klassing/Halloween_Ghost/Hardware/_Release_Files_/SCM/Halloween_Ghost_v1_scm.pdf

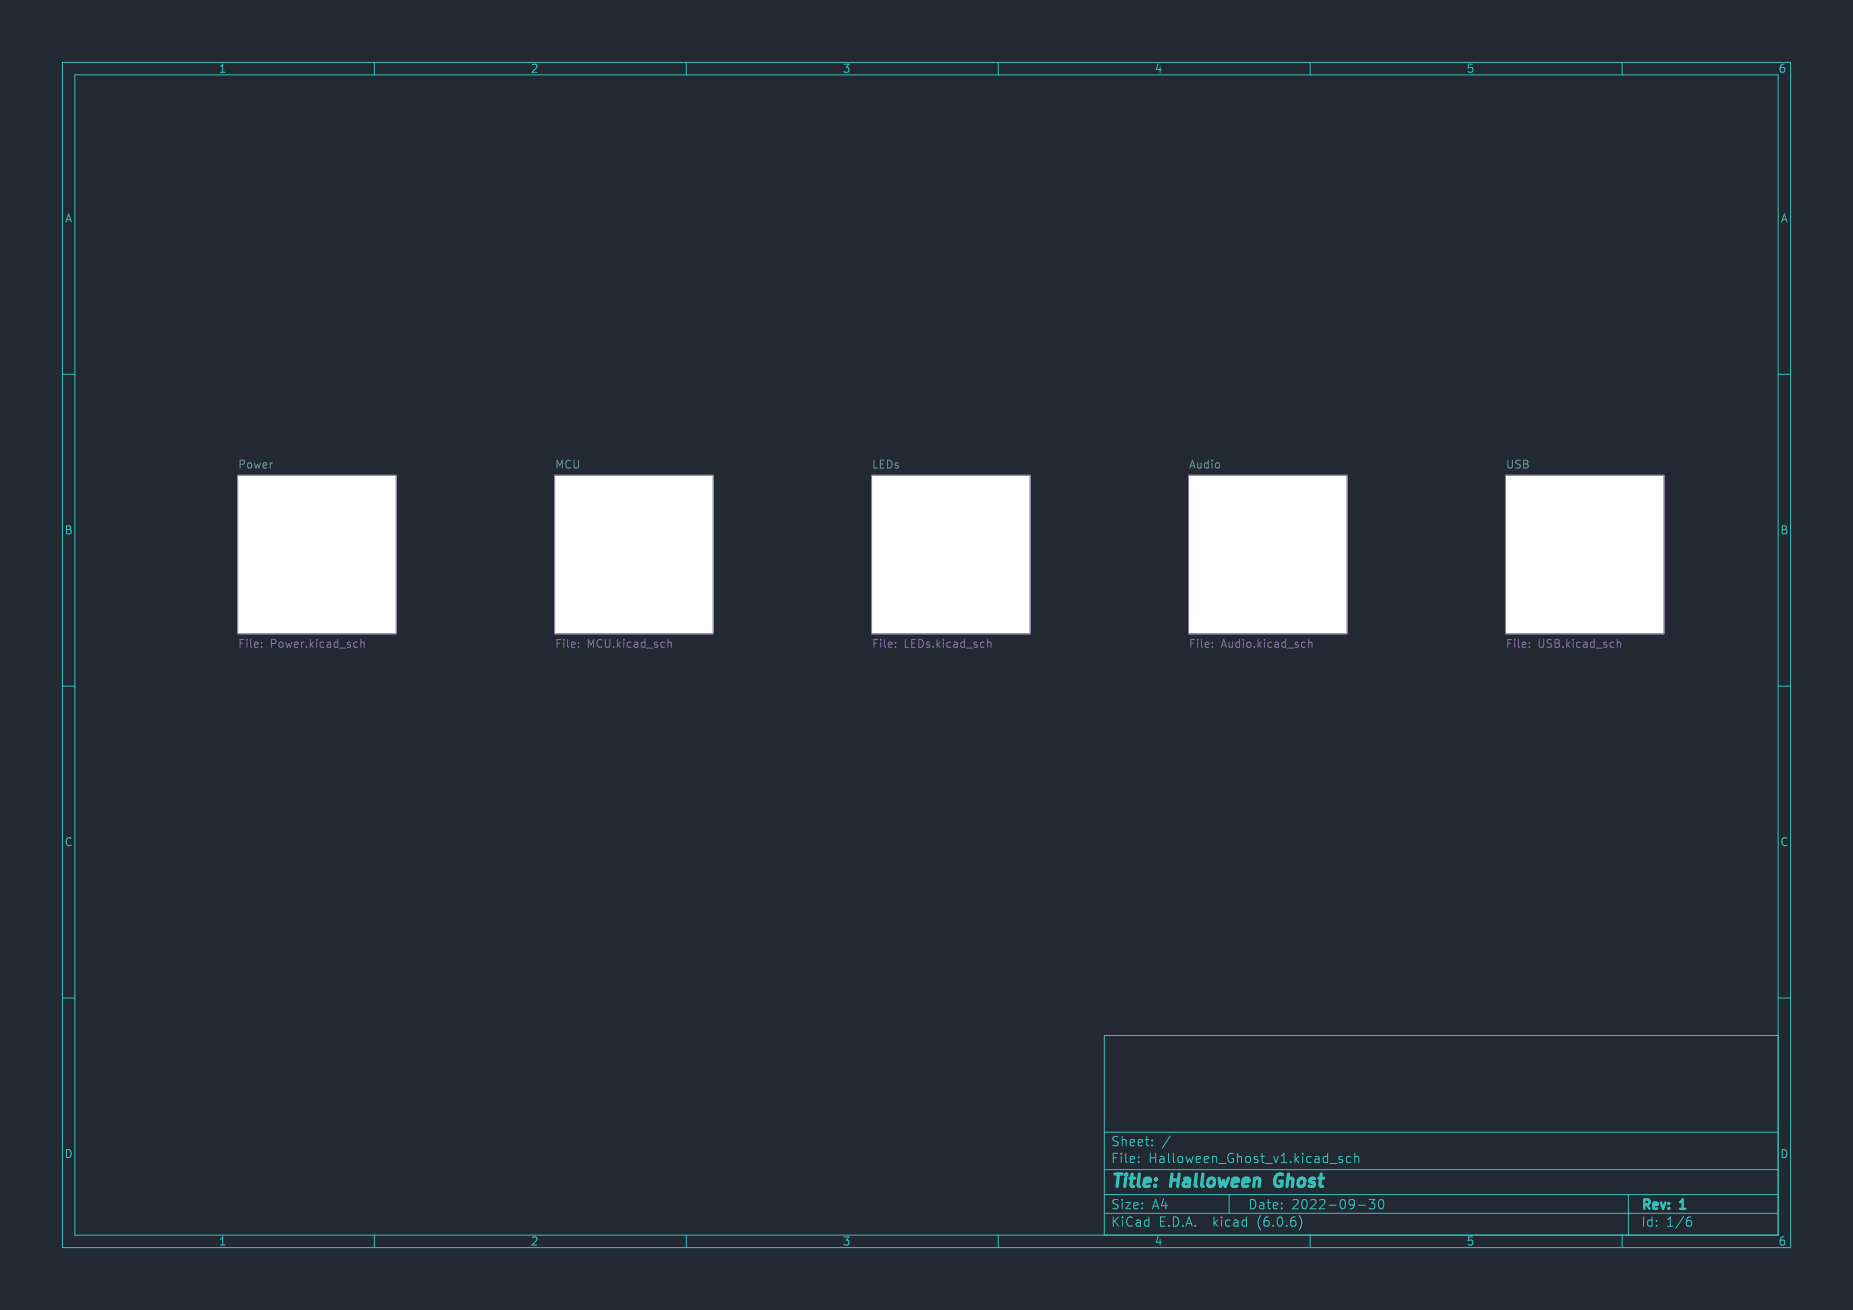
[picture p1: page 1]

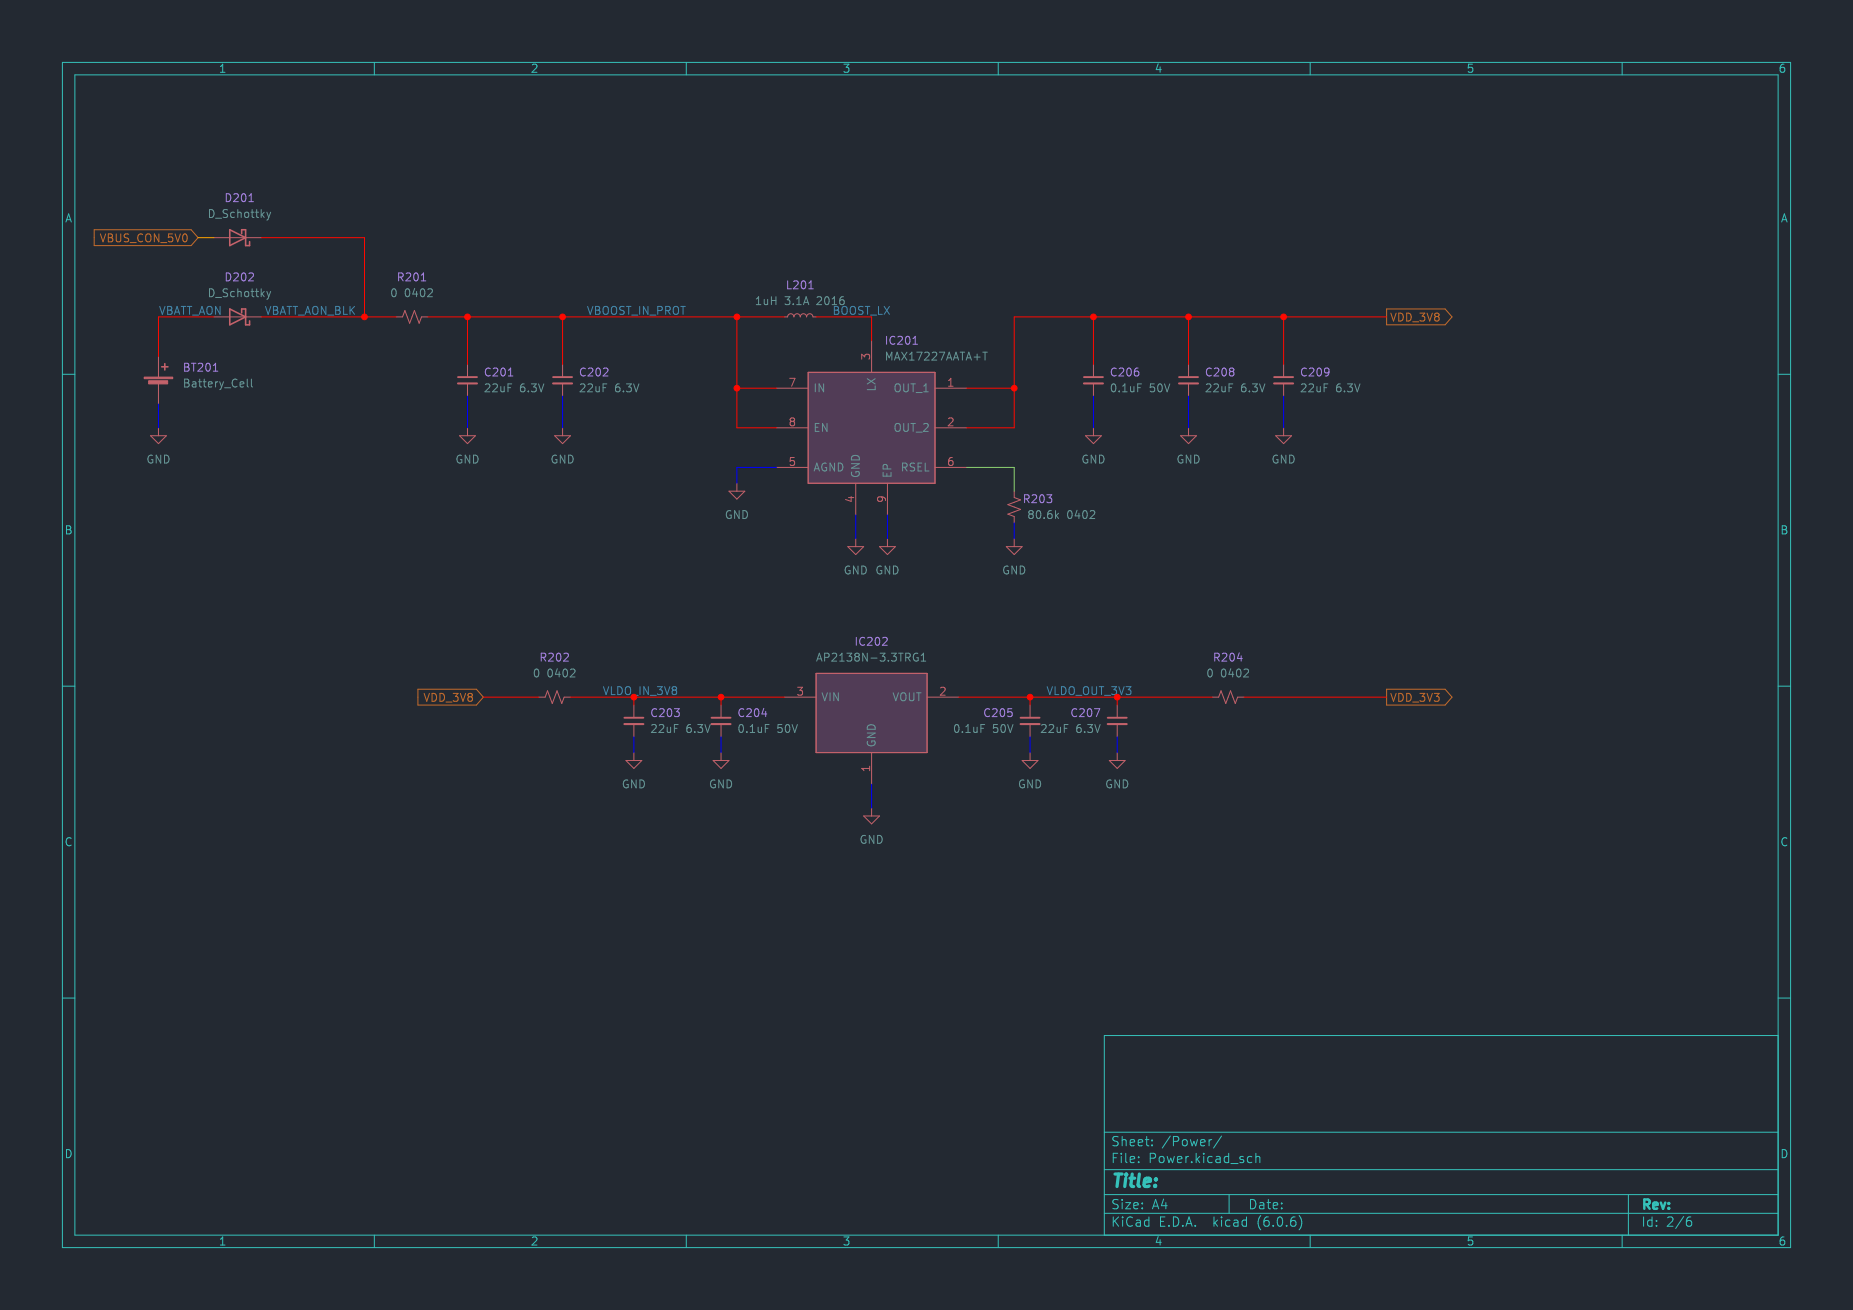
[picture p2: page 2]

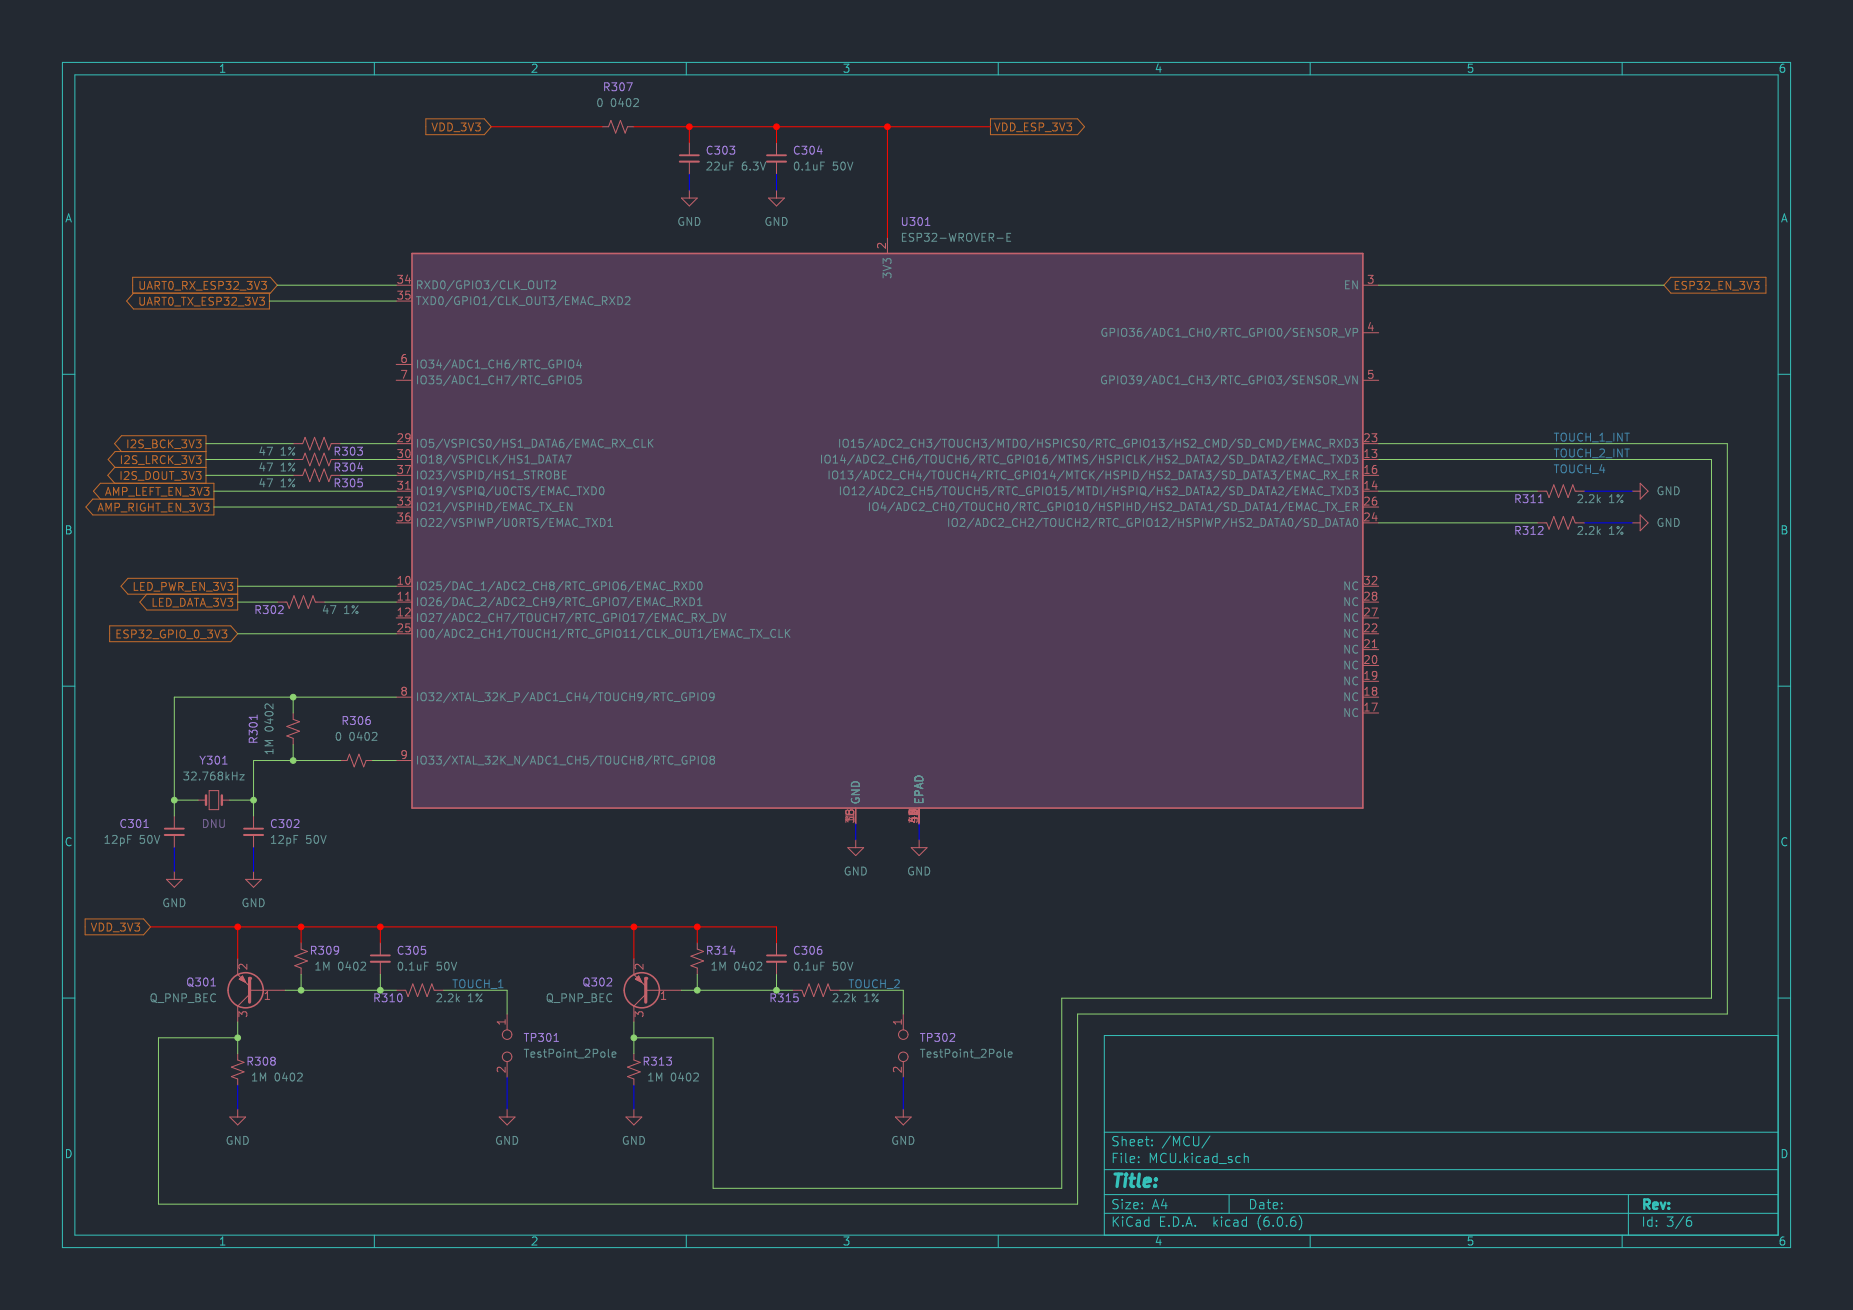
[picture p3: page 3]

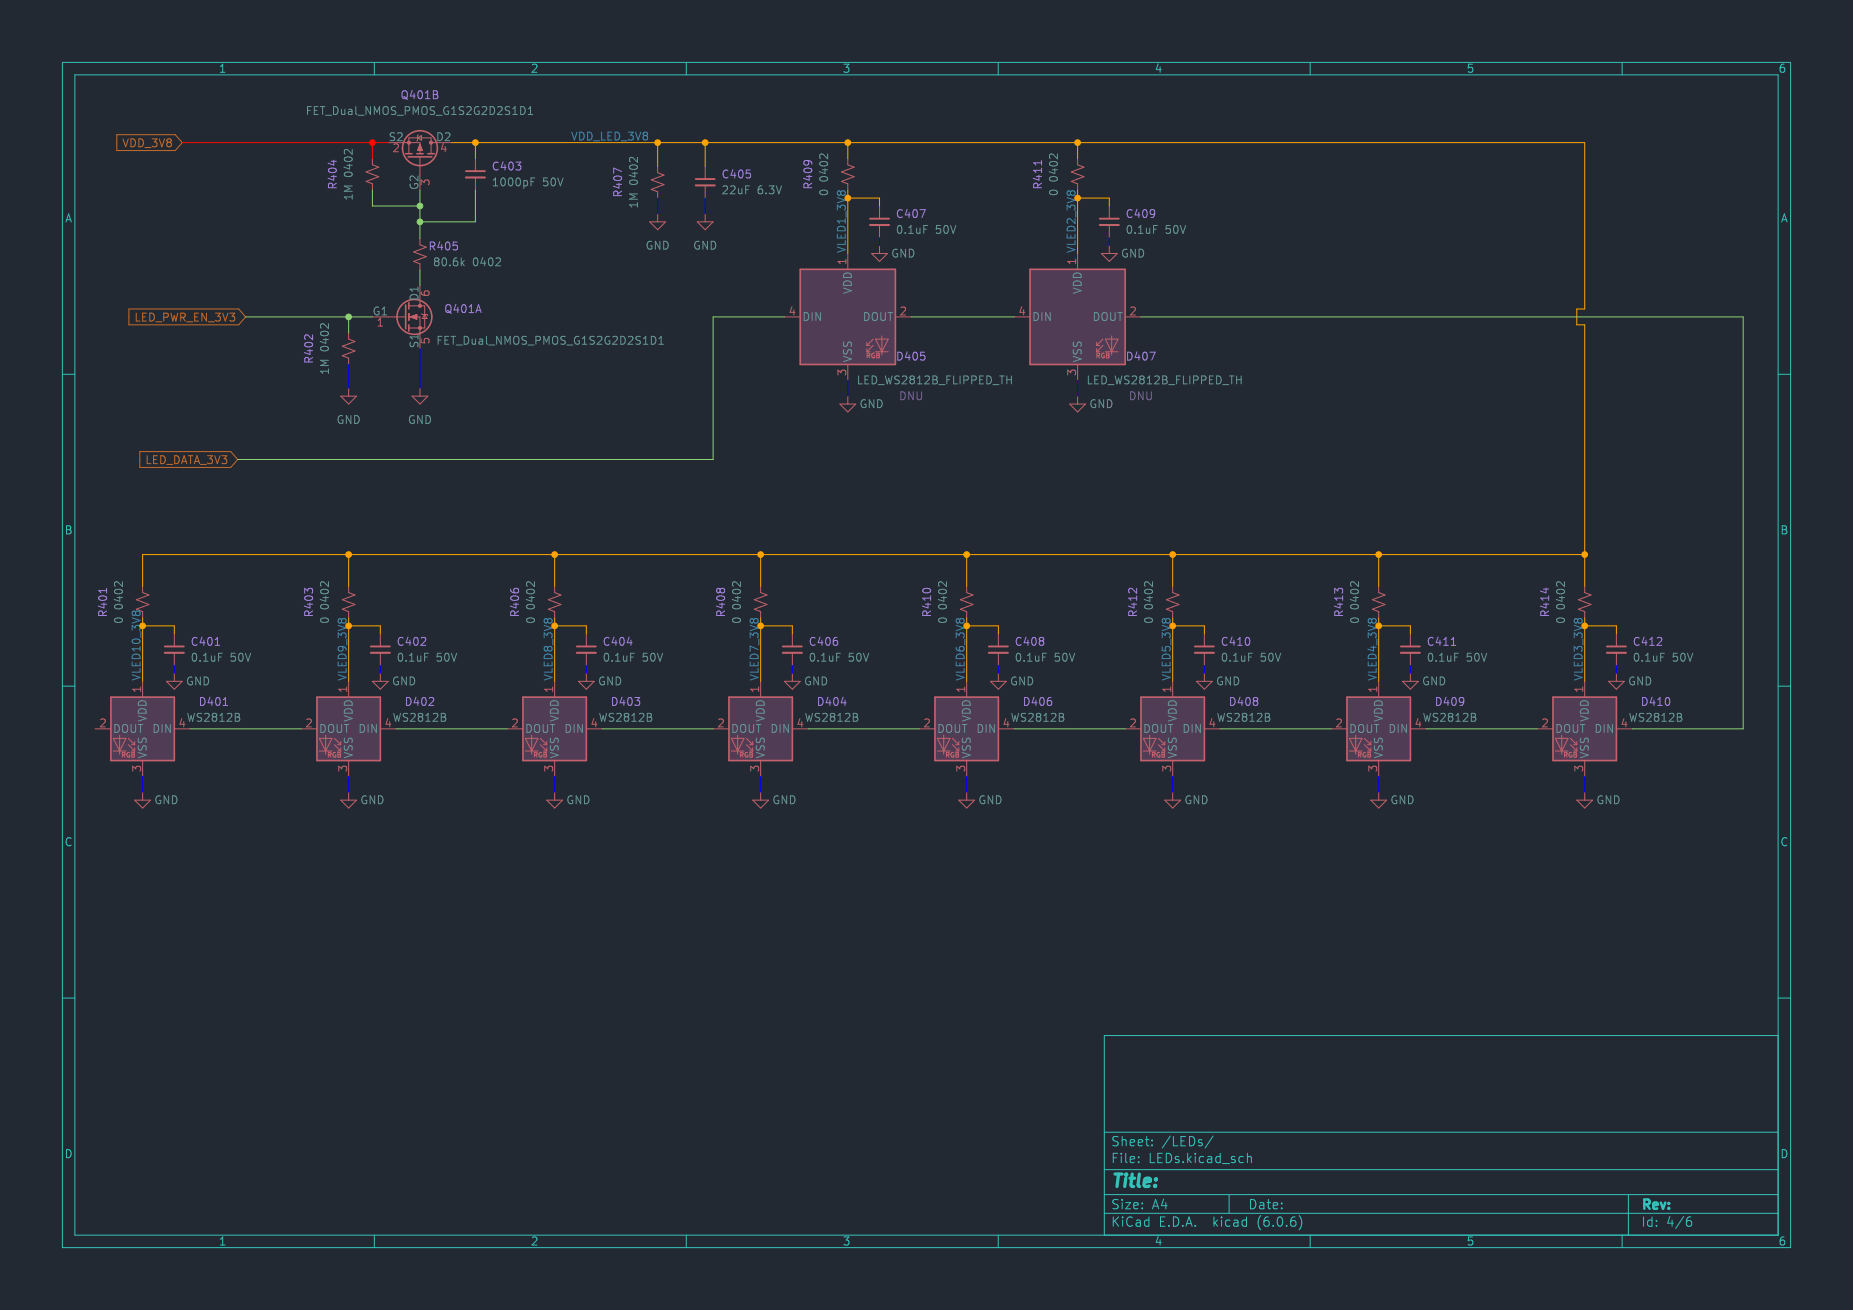
[picture p4: page 4]

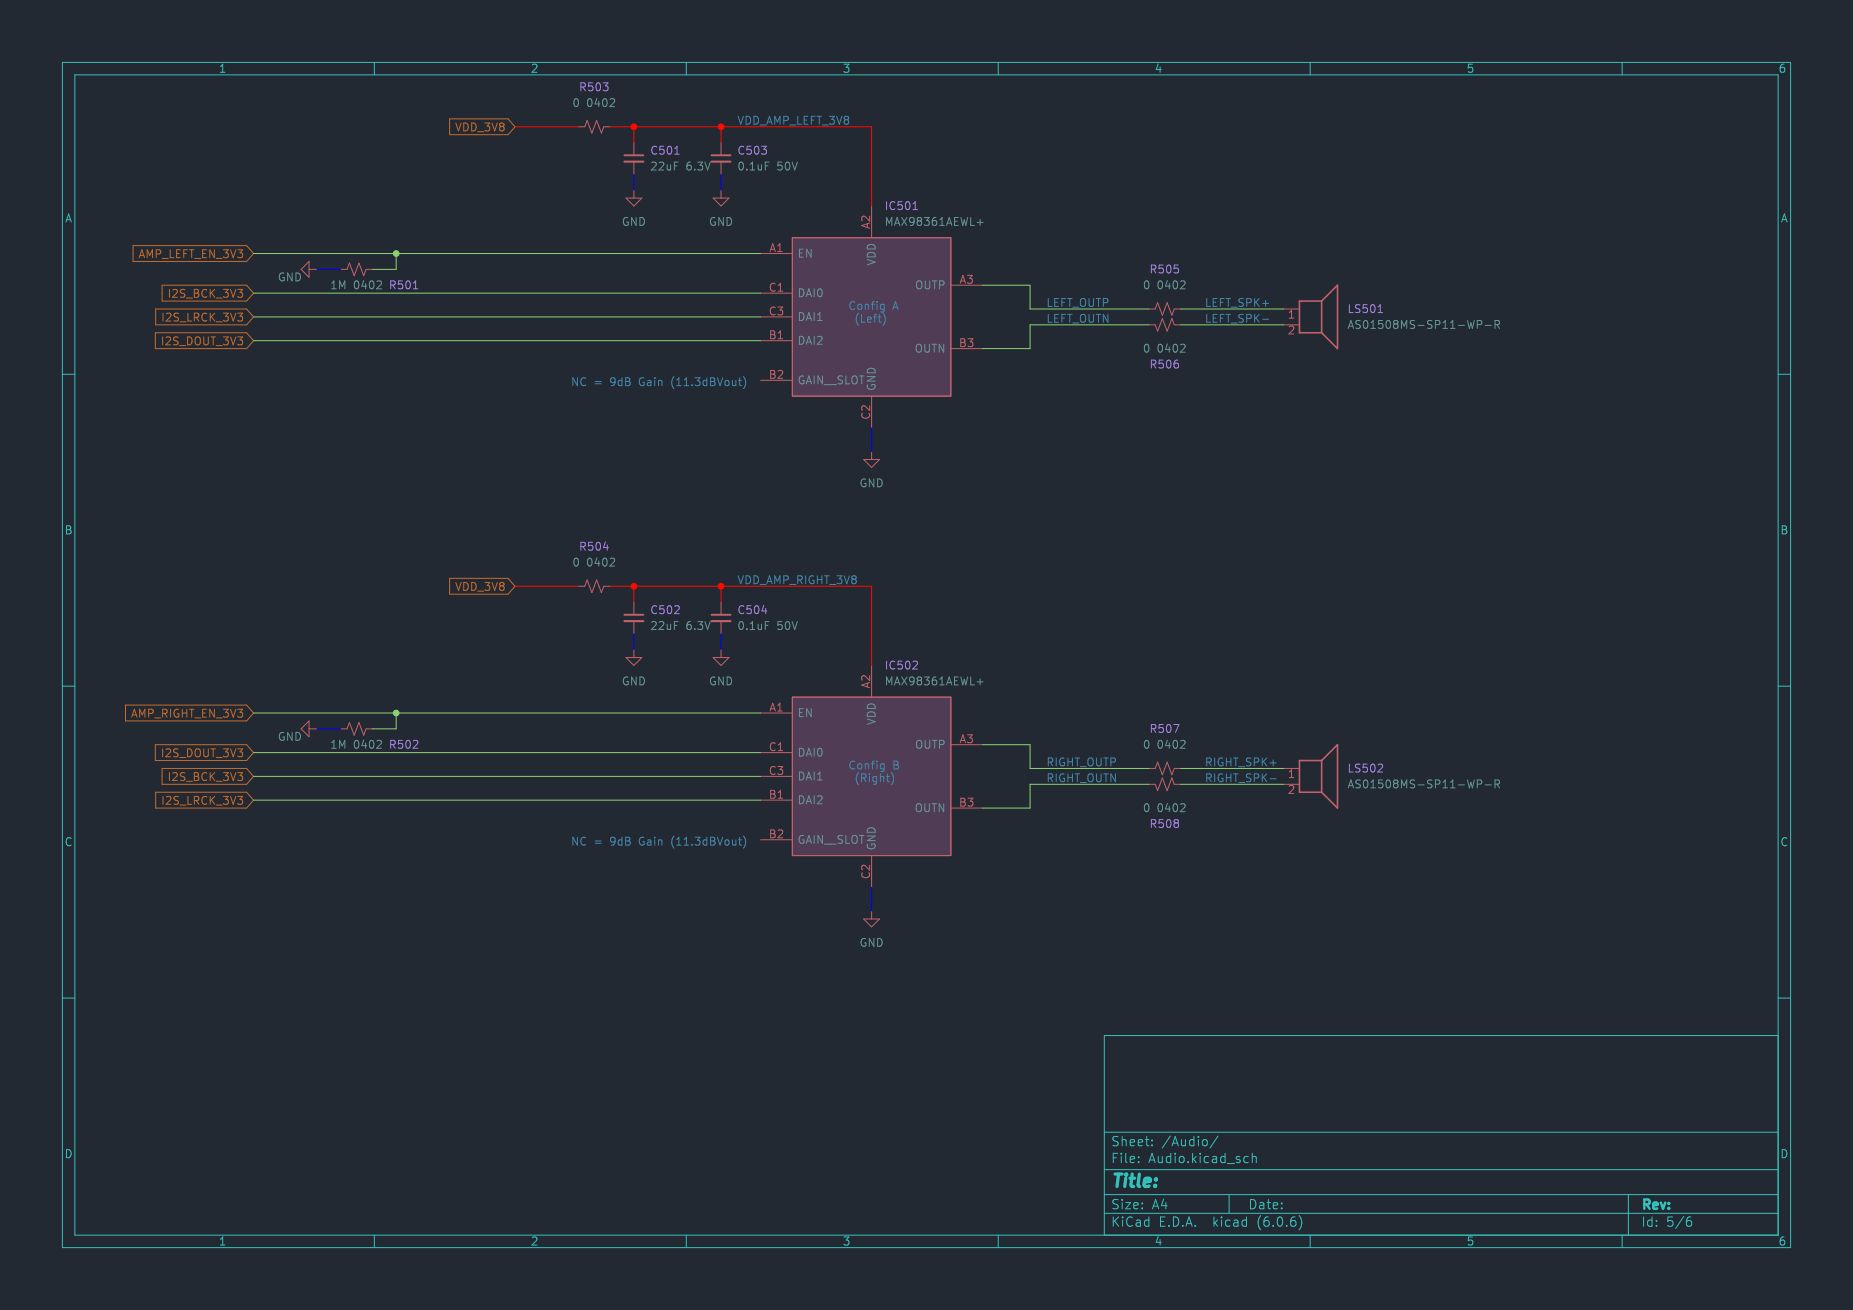
[picture p5: page 5]

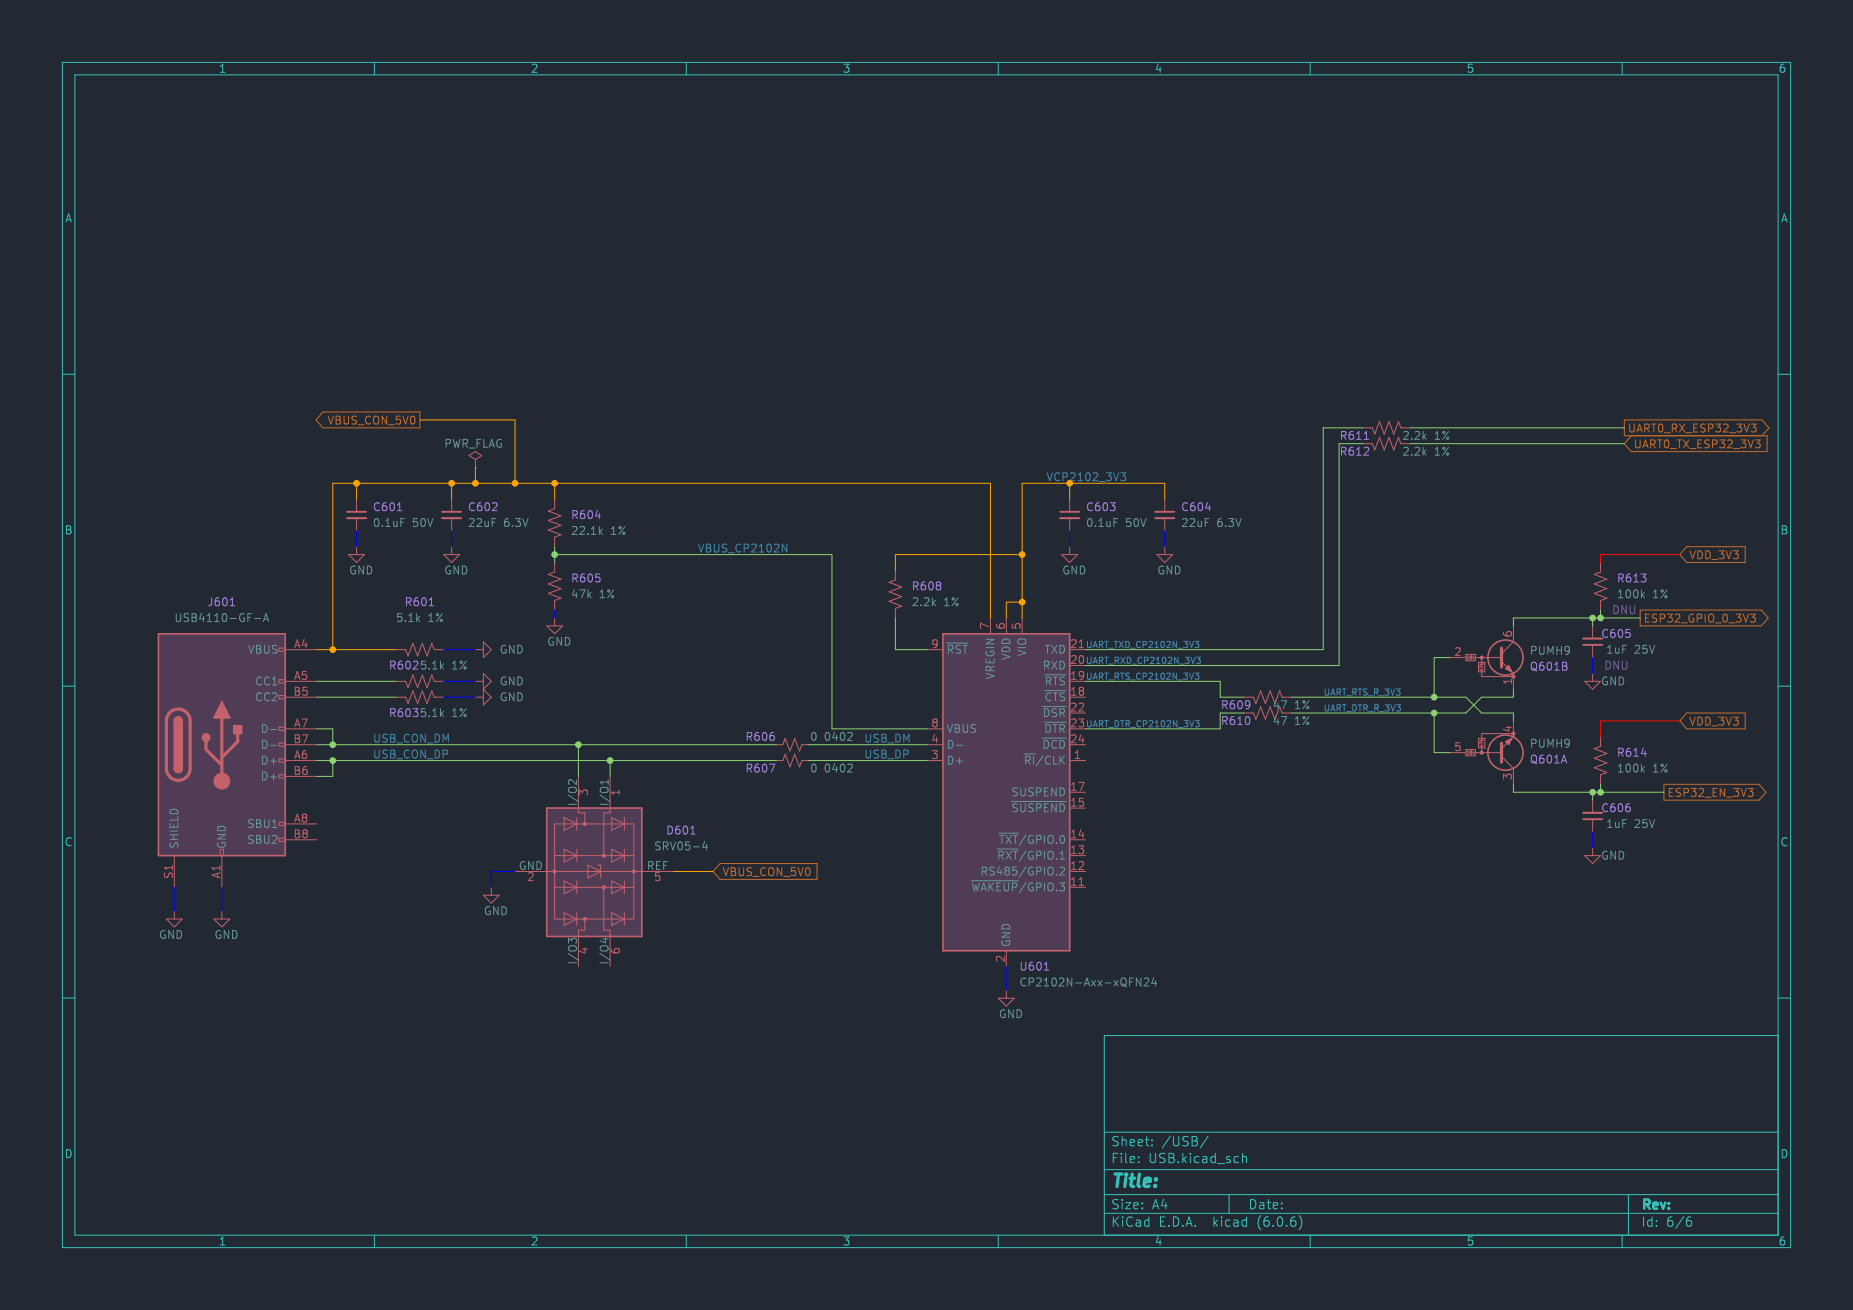
[picture p6: page 6]
