klassing/Halloween_Ghost/Hardware/CAD/Halloween_Ghost_v1.kicad_pcb

## KiCad design Hardware/CAD/Halloween_Ghost_v1.kicad_pcb (2022-10-20)

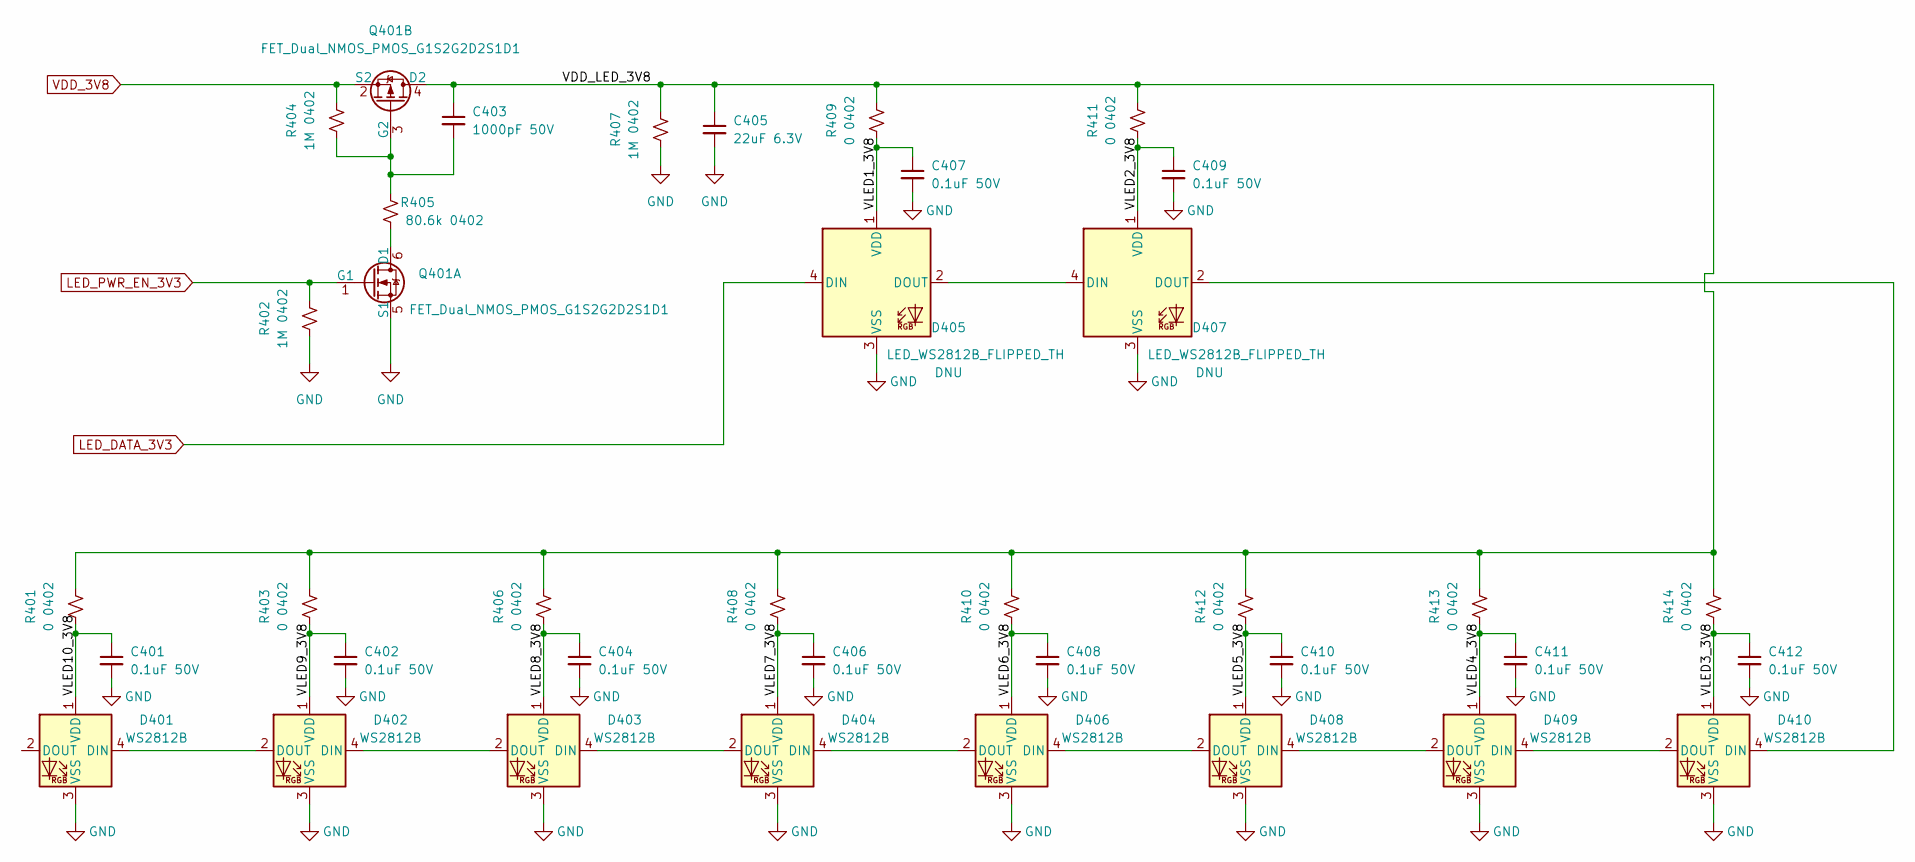
[picture p7: schematic LEDs.kicad_sch]

Parts:
C401, C402, C404, C406, C407, C408, C409, C410, C411, C412: 0.1uF 50V; C_0402_1005Metric; JLC_Cost 0.0061
C403: 1000pF 50V; C_0402_1005Metric; JLC_Cost 0.001
C405: 22uF 6.3V; C_0603_1608Metric; JLC_Cost 0.0044
D401, D402, D403, D404, D406, D408, D409, D410: WS2812B; LED_WS2812B_PLCC4_5.0x5.0mm_P3.2mm; JLC_Cost 0.0962
D405, D407: LED_WS2812B_FLIPPED_TH; Manufacturer_Part_Number WS2812B-V5/W
Q401: FET_Dual_NMOS_PMOS_G1S2G2D2S1D1; TSOT-23-6; JLC_Cost 0.1041
R401, R403, R406, R408, R409, R410, R411, R412, R413, R414: 0 0402; R_0402_1005Metric; JLC_Cost 0.0005
R402, R404, R407: 1M 0402; R_0402_1005Metric; JLC_Cost 0.0005
R405: 80.6k 0402; R_0402_1005Metric; JLC_Cost 0.0005

Connections:
/LEDs/VDD_LED_3V8: C403.1, C405.1, Q401.4 (D2), R401.2, R403.2, R406.2, R407.2, R408.2, R409.2, R410.2, R411.2, R412.2, R413.2, R414.2
/LEDs/VLED1_3V8: C407.1, D405.1 (VDD), R409.1
/LEDs/VLED2_3V8: C409.1, D407.1 (VDD), R411.1
/LEDs/VLED3_3V8: C412.1, D410.1 (VDD), R414.1
/LEDs/VLED4_3V8: C411.1, D409.1 (VDD), R413.1
/LEDs/VLED5_3V8: C410.1, D408.1 (VDD), R412.1
/LEDs/VLED6_3V8: C408.1, D406.1 (VDD), R410.1
/LEDs/VLED7_3V8: C406.1, D404.1 (VDD), R408.1
/LEDs/VLED8_3V8: C404.1, D403.1 (VDD), R406.1
/LEDs/VLED9_3V8: C402.1, D402.1 (VDD), R403.1
/LEDs/VLED10_3V8: C401.1, D401.1 (VDD), R401.1
GND: C401.2, C402.2, C404.2, C405.2, C406.2, C407.2, C408.2, C409.2, C410.2, C411.2, C412.2, D401.3 (VSS), D402.3 (VSS), D403.3 (VSS), D404.3 (VSS), D405.3 (VSS), D406.3 (VSS), D407.3 (VSS), D408.3 (VSS), D409.3 (VSS), D410.3 (VSS), Q401.5 (S1), R402.1, R407.1; also elsewhere on the board
LED_DATA_3V3: D405.4 (DIN); also elsewhere on the board
LED_PWR_EN_3V3: Q401.1 (G1), R402.2; also elsewhere on the board
unnamed: C403.2, Q401.3 (G2), R404.1, R405.2
unnamed: D401.4 (DIN), D402.2 (DOUT)
unnamed: D402.4 (DIN), D403.2 (DOUT)
unnamed: D403.4 (DIN), D404.2 (DOUT)
unnamed: D404.4 (DIN), D406.2 (DOUT)
unnamed: D405.2 (DOUT), D407.4 (DIN)
unnamed: D406.4 (DIN), D408.2 (DOUT)
unnamed: D407.2 (DOUT), D410.4 (DIN)
unnamed: D408.4 (DIN), D409.2 (DOUT)
unnamed: D409.4 (DIN), D410.2 (DOUT)
unnamed: Q401.6 (D1), R405.1
VDD_3V8: Q401.2 (S2), R404.2; also elsewhere on the board

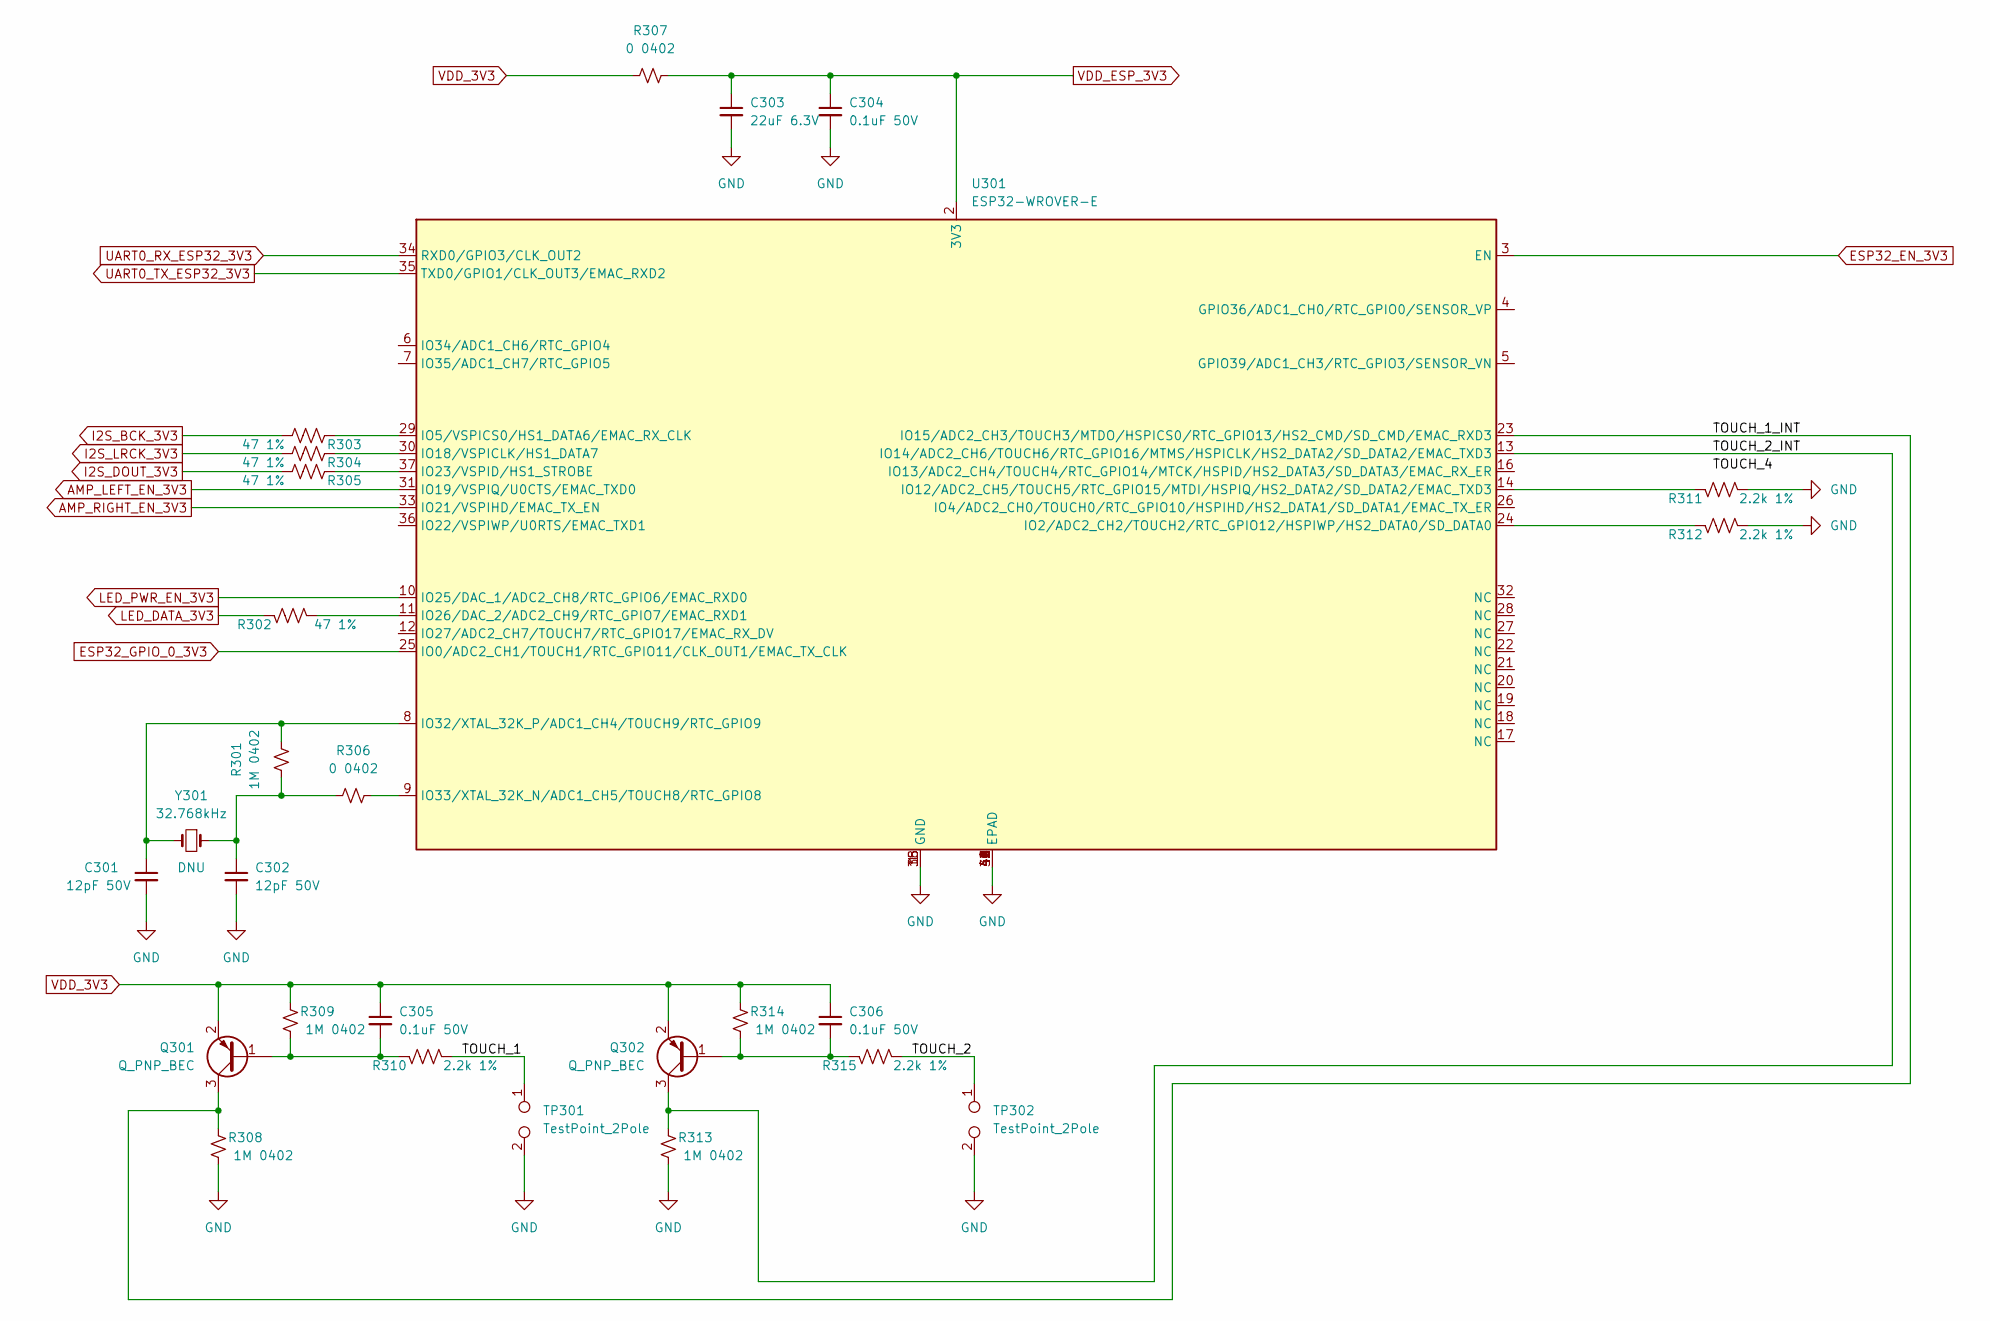
[picture p8: schematic MCU.kicad_sch]

Parts:
C301, C302: 12pF 50V; C_0402_1005Metric; JLC_Cost 0.0061
C303: 22uF 6.3V; C_0603_1608Metric; JLC_Cost 0.0044
C304, C305, C306: 0.1uF 50V; C_0402_1005Metric; JLC_Cost 0.0061
Q301, Q302: Q_PNP_BEC; SOT-23; JLC_Cost 0.0147
R301, R308, R309, R313, R314: 1M 0402; R_0402_1005Metric; JLC_Cost 0.0005
R302, R303, R304, R305: 47 1%; R_0402_1005Metric; Manufacturer_Part_Number RMC10K470FTH; Mouser Part Number 791-RMC10K470FTH
R306, R307: 0 0402; R_0402_1005Metric; JLC_Cost 0.0005
R310, R311, R312, R315: 2.2k 1%; R_0402_1005Metric; Manufacturer_Part_Number RMC10K222FTH; Mouser Part Number 791-RMC10K222FTH
TP301, TP302: TestPoint_2Pole
U301: ESP32-WROVER-E; JLC_MPN ESP32-WROVER-E-N8R8
Y301: 32.768kHz; Crystal_SMD_3215-2Pin_3.2x1.5mm; JLC_Cost 0.2034

Connections:
/MCU/TOUCH_1: R310.1, TP301.1
/MCU/TOUCH_1_INT: Q301.3 (C), R308.1, U301.23 (IO15/ADC2_CH3/TOUCH3/MTDO/HSPICS0/RTC_G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)
/MCU/TOUCH_2: R315.1, TP302.1
/MCU/TOUCH_2_INT: Q302.3 (C), R313.1, U301.13 (IO14/ADC2_CH6/TOUCH6/RTC_GPIO16/MTMS/HS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)
AMP_LEFT_EN_3V3: U301.31 (IO19/VSPIQ/U0CTS/EMAC_TXD0); also elsewhere on the board
AMP_RIGHT_EN_3V3: U301.33 (IO21/VSPIHD/EMAC_TX_EN); also elsewhere on the board
ESP32_EN_3V3: U301.3 (EN); also elsewhere on the board
ESP32_GPIO_0_3V3: U301.25 (IO0/ADC2_CH1/TOUCH1/RTC_GPIO11/CLK_OUT1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); also elsewhere on the board
GND: C301.2, C302.2, C303.2, C304.2, R308.2, R311.1, R312.1, R313.2, TP301.2, TP302.2, U301.1 (GND), U301.15 (GND), U301.38 (GND), U301.39 (EPAD), U301.40 (EPAD), U301.41 (EPAD), U301.42 (EPAD), U301.43 (EPAD), U301.44 (EPAD), U301.45 (EPAD), U301.46 (EPAD), U301.47 (EPAD); also elsewhere on the board
I2S_BCK_3V3: R303.1; also elsewhere on the board
I2S_DOUT_3V3: R305.1; also elsewhere on the board
I2S_LRCK_3V3: R304.1; also elsewhere on the board
LED_DATA_3V3: R302.2; also elsewhere on the board
LED_PWR_EN_3V3: U301.10 (IO25/DAC_1/ADC2_CH8/RTC_GPIO6/EMAC_RXD0); also elsewhere on the board
unnamed: C301.1, R301.2, U301.8 (IO32/XTAL_32K_P/ADC1_CH4/TOUCH9/RTC_GPI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), Y301.2
unnamed: C302.1, R301.1, R306.1, Y301.1
unnamed: C305.2, Q301.1 (B), R309.2, R310.2
unnamed: C306.2, Q302.1 (B), R314.2, R315.2
unnamed: R302.1, U301.11 (IO26/DAC_2/ADC2_CH9/RTC_GPIO7/EMAC_RXD1)
unnamed: R303.2, U301.29 (IO5/VSPICS0/HS1_DATA6/EMAC_RX_CLK)
unnamed: R304.2, U301.30 (IO18/VSPICLK/HS1_DATA7)
unnamed: R305.2, U301.37 (IO23/VSPID/HS1_STROBE)
unnamed: R306.2, U301.9 (IO33/XTAL_32K_N/ADC1_CH5/TOUCH8/RTC_GPI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)
unnamed: R311.2, U301.14 (IO12/ADC2_CH5/TOUCH5/RTC_GPIO15/MTDI/HS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)
unnamed: R312.2, U301.24 (IO2/ADC2_CH2/TOUCH2/RTC_GPIO12/HSPIWP/H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)
UART0_RX_ESP32_3V3: U301.34 (RXD0/GPIO3/CLK_OUT2); also elsewhere on the board
UART0_TX_ESP32_3V3: U301.35 (TXD0/GPIO1/CLK_OUT3/EMAC_RXD2); also elsewhere on the board
VDD_3V3: C305.1, C306.1, Q301.2 (E), Q302.2 (E), R307.1, R309.1, R314.1; also elsewhere on the board
VDD_ESP_3V3: C303.1, C304.1, R307.2, U301.2 (3V3)

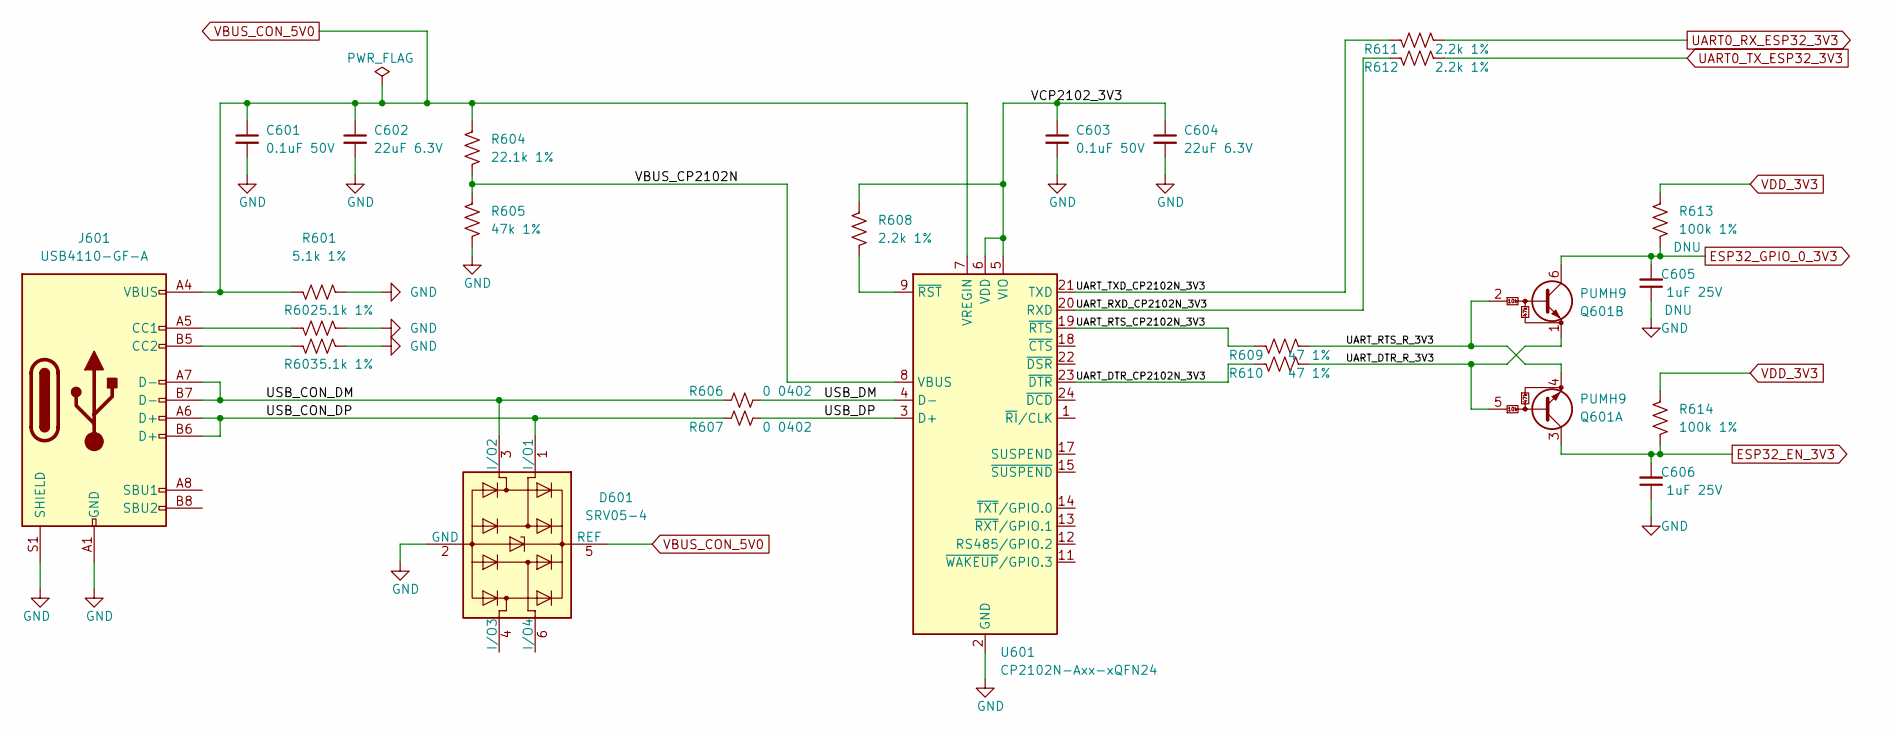
[picture p9: schematic USB.kicad_sch]

Parts:
C601, C603: 0.1uF 50V; C_0402_1005Metric; JLC_Cost 0.0061
C602, C604: 22uF 6.3V; C_0603_1608Metric; JLC_Cost 0.0044
C605, C606: 1uF 25V; C_0402_1005Metric; JLC_Type Basic
D601: SRV05-4; SOT-23-6; JLC_Cost 0.1181
J601: USB4110-GF-A; JLC_Cost 0.1104
Q601: PUMH9; SOT-363_SC-70-6; Manufacturer_Part_Number PUMH9,115; Mouser Part Number 771-PUMH9-T/R
R601, R602, R603: 5.1k 1%; R_0402_1005Metric; Manufacturer_Part_Number RMC10K512FTH; Mouser Part Number 791-RMC10K512FTH
R604: 22.1k 1%; R_0402_1005Metric; Manufacturer_Part_Number RC0402FR-0722K1L; Mouser Part Number 603-RC0402FR-0722K1L
R605: 47k 1%; R_0402_1005Metric; Manufacturer_Part_Number RMC10K473FTH; Mouser Part Number 791-RMC10K473FTH
R606, R607: 0 0402; R_0402_1005Metric; JLC_Cost 0.0005
R608, R611, R612: 2.2k 1%; R_0402_1005Metric; Manufacturer_Part_Number RMC10K222FTH; Mouser Part Number 791-RMC10K222FTH
R609, R610: 47 1%; R_0402_1005Metric; Manufacturer_Part_Number RMC10K470FTH; Mouser Part Number 791-RMC10K470FTH
R613, R614: 100k 1%; R_0402_1005Metric; Manufacturer_Part_Number RMC10K104FTH; Mouser Part Number 791-RMC10K104FTH
U601: CP2102N-Axx-xQFN24; QFN-24-1EP_4x4mm_P0.5mm_EP2.6x2.6mm; Manufacturer_Part_Number CP2102N-A02-GQFN24; Mouser Part Number 634-CP2102NA02GQFN24

Connections:
/USB/UART_DTR_CP2102N_3V3: R610.2, U601.23 (~DTR)
/USB/UART_DTR_R_3V3: Q601.1 (E2), Q601.5 (B1), R610.1
/USB/UART_RTS_CP2102N_3V3: R609.2, U601.19 (~RTS)
/USB/UART_RTS_R_3V3: Q601.2 (B2), Q601.4 (E1), R609.1
/USB/UART_RXD_CP2102N_3V3: R612.2, U601.20 (RXD)
/USB/UART_TXD_CP2102N_3V3: R611.2, U601.21 (TXD)
/USB/USB_CON_DM: D601.3 (I/O2), J601.A7 (D-), J601.B7 (D-), R606.1
/USB/USB_CON_DP: D601.1 (I/O1), J601.A6 (D+), J601.B6 (D+), R607.1
/USB/USB_DM: R606.2, U601.4 (D-)
/USB/USB_DP: R607.2, U601.3 (D+)
/USB/VBUS_CP2102N: R604.2, R605.1, U601.8 (VBUS)
/USB/VCP2102_3V3: C603.1, C604.1, R608.1, U601.5 (VIO), U601.6 (VDD)
ESP32_EN_3V3: C606.2, Q601.3 (C1), R614.2; also elsewhere on the board
ESP32_GPIO_0_3V3: C605.2, Q601.6 (C2), R613.2; also elsewhere on the board
GND: C601.2, C602.2, C603.2, C604.2, C605.1, C606.1, D601.2 (GND), J601.A1 (GND), J601.A12 (GND), J601.B1 (GND), J601.B12 (GND), J601.S1 (SHIELD), R601.2, R602.1, R603.1, R605.2, U601.2 (GND), U601.25 (GND); also elsewhere on the board
unnamed: J601.A5 (CC1), R602.2
unnamed: J601.B5 (CC2), R603.2
unnamed: R608.2, U601.9 (~RST)
UART0_RX_ESP32_3V3: R611.1; also elsewhere on the board
UART0_TX_ESP32_3V3: R612.1; also elsewhere on the board
VBUS_CON_5V0: C601.1, C602.1, D601.5 (REF), J601.A4 (VBUS), J601.A9 (VBUS), J601.B4 (VBUS), J601.B9 (VBUS), R601.1, R604.1, U601.7 (VREGIN); also elsewhere on the board
VDD_3V3: R613.1, R614.1; also elsewhere on the board

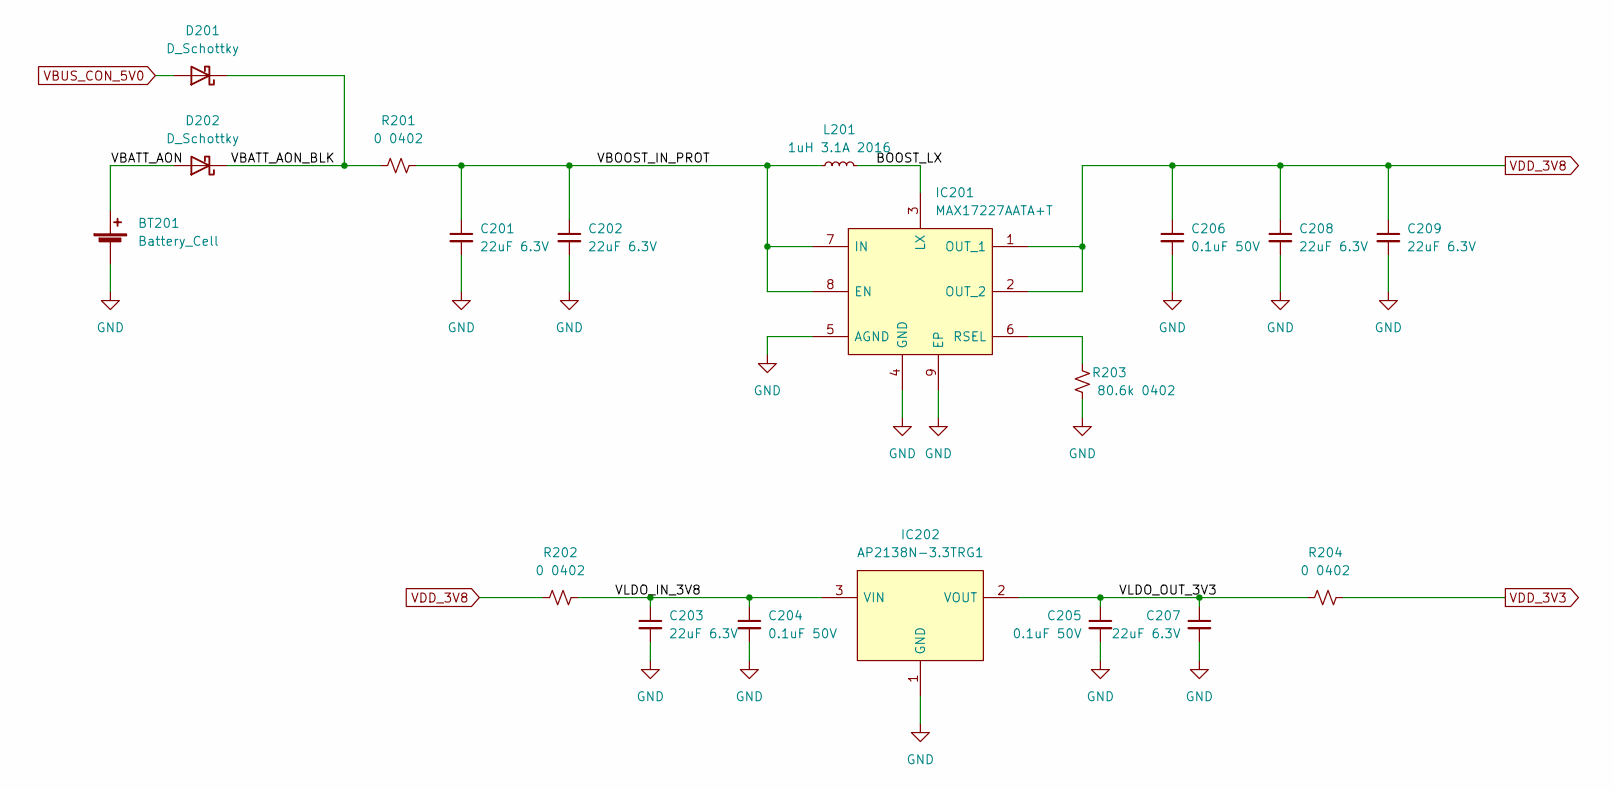
[picture p10: schematic Power.kicad_sch]

Parts:
BT201: Battery_Cell; BatteryHolder_Keystone_1128_1xCR123A_lifted; Manufacturer_Part_Number 1128
C201, C202, C203, C207, C208, C209: 22uF 6.3V; C_0603_1608Metric; JLC_Cost 0.0044
C204, C205, C206: 0.1uF 50V; C_0402_1005Metric; JLC_Cost 0.0061
D201, D202: D_Schottky; D_SOD-323; JLC_Cost 0.0147
IC201: MAX17227AATA+T; TDFN-8-EP_2.0x2.0x0.80_P0.5mm; Mouser Part Number 700-MAX17227AATA+T
IC202: AP2138N-3.3TRG1; SOT-23-3_DiodesINC; Mouser Part Number 621-AP2138N-3.3TRG1
L201: 1uH 3.1A 2016; L_0806_2016Metric; JLC_Cost 0.0975
R201, R202, R204: 0 0402; R_0402_1005Metric; JLC_Cost 0.0005
R203: 80.6k 0402; R_0402_1005Metric; JLC_Cost 0.0005

Connections:
/Power/BOOST_LX: IC201.3 (LX), L201.2
/Power/VBATT_AON: BT201.1 (+), D202.2 (A)
/Power/VBATT_AON_BLK: D201.1 (K), D202.1 (K), R201.1
/Power/VBOOST_IN_PROT: C201.1, C202.1, IC201.7 (IN), IC201.8 (EN), L201.1, R201.2
/Power/VLDO_IN_3V8: C203.1, C204.1, IC202.3 (VIN), R202.2
/Power/VLDO_OUT_3V3: C205.1, C207.1, IC202.2 (VOUT), R204.1
GND: BT201.2 (-), C201.2, C202.2, C203.2, C204.2, C205.2, C206.2, C207.2, C208.2, C209.2, IC201.4 (GND), IC201.5 (AGND), IC201.9 (EP), IC202.1 (GND), R203.1; also elsewhere on the board
unnamed: IC201.6 (RSEL), R203.2
VBUS_CON_5V0: D201.2 (A); also elsewhere on the board
VDD_3V3: R204.2; also elsewhere on the board
VDD_3V8: C206.1, C208.1, C209.1, IC201.1 (OUT_1), IC201.2 (OUT_2), R202.1; also elsewhere on the board

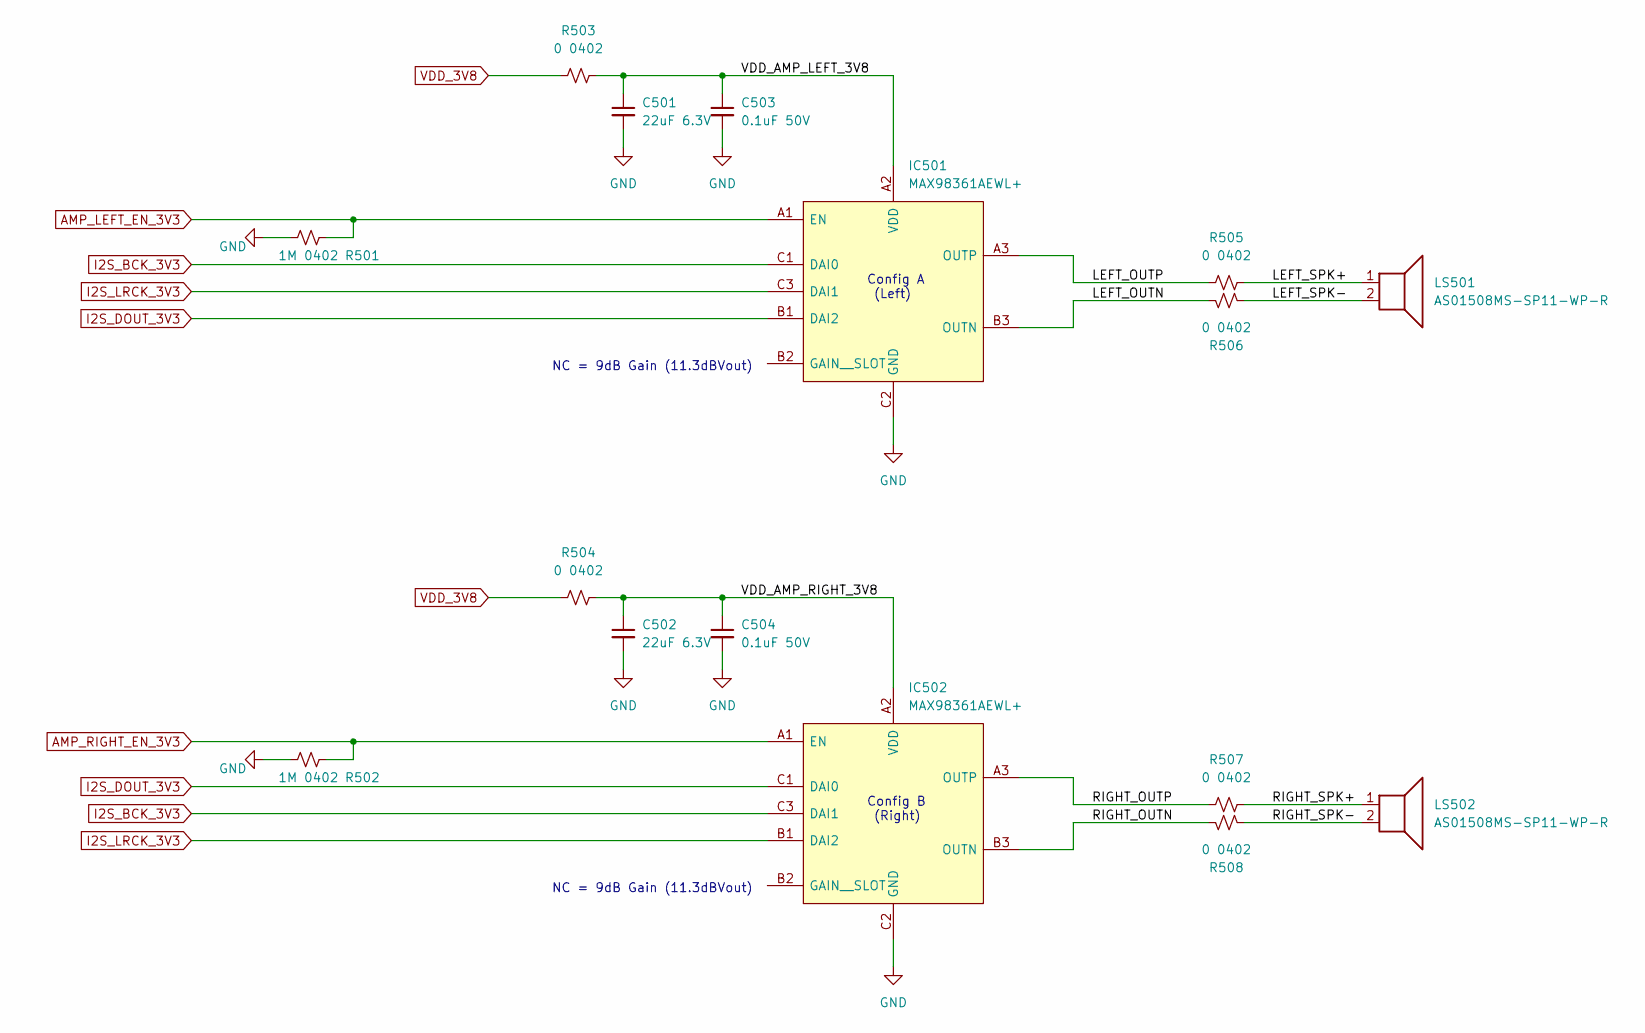
[picture p11: schematic Audio.kicad_sch]

Parts:
C501, C502: 22uF 6.3V; C_0603_1608Metric; JLC_Cost 0.0044
C503, C504: 0.1uF 50V; C_0402_1005Metric; JLC_Cost 0.0061
IC501, IC502: MAX98361AEWL+; BGA9C40P3X3_144X135X69; Manufacturer_Part_Number MAX98361AEWL+
LS501, LS502: AS01508MS-SP11-WP-R
R501, R502: 1M 0402; R_0402_1005Metric; JLC_Cost 0.0005
R503, R504, R505, R506, R507, R508: 0 0402; R_0402_1005Metric; JLC_Cost 0.0005

Connections:
/Audio/LEFT_OUTN: IC501.B3 (OUTN), R506.1
/Audio/LEFT_OUTP: IC501.A3 (OUTP), R505.1
/Audio/LEFT_SPK+: LS501.1, R505.2
/Audio/LEFT_SPK-: LS501.2, R506.2
/Audio/RIGHT_OUTN: IC502.B3 (OUTN), R508.1
/Audio/RIGHT_OUTP: IC502.A3 (OUTP), R507.1
/Audio/RIGHT_SPK+: LS502.1, R507.2
/Audio/RIGHT_SPK-: LS502.2, R508.2
/Audio/VDD_AMP_LEFT_3V8: C501.1, C503.1, IC501.A2 (VDD), R503.2
/Audio/VDD_AMP_RIGHT_3V8: C502.1, C504.1, IC502.A2 (VDD), R504.2
AMP_LEFT_EN_3V3: IC501.A1 (EN), R501.1; also elsewhere on the board
AMP_RIGHT_EN_3V3: IC502.A1 (EN), R502.1; also elsewhere on the board
GND: C501.2, C502.2, C503.2, C504.2, IC501.C2 (GND), IC502.C2 (GND), R501.2, R502.2; also elsewhere on the board
I2S_BCK_3V3: IC501.C1 (DAI0), IC502.C3 (DAI1); also elsewhere on the board
I2S_DOUT_3V3: IC501.B1 (DAI2), IC502.C1 (DAI0); also elsewhere on the board
I2S_LRCK_3V3: IC501.C3 (DAI1), IC502.B1 (DAI2); also elsewhere on the board
VDD_3V8: R503.1, R504.1; also elsewhere on the board

Notes on the sheet:
NC = 9dB Gain (11.3dBVout)
Config A (Left)
Config B (Right)

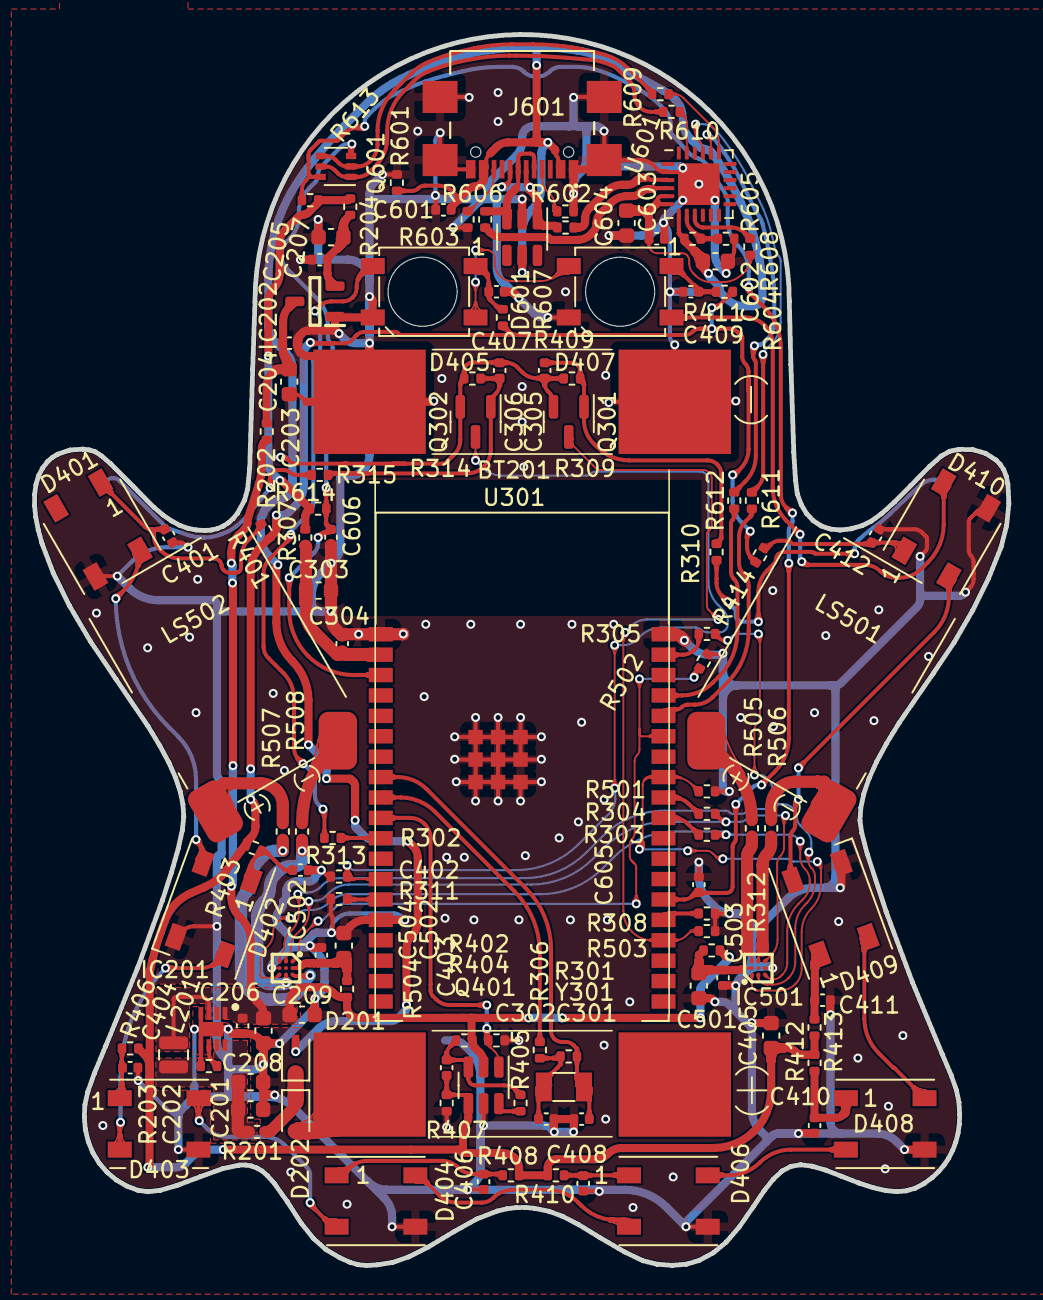
[picture p12: board Halloween_Ghost_v1.kicad_pcb from above]

Board: 2 copper layers, 60.7 x 76.6 mm, 121 parts (0 on the bottom side), 83 nets.
